MaishaMagavha/Data-Acquisition-Processing-and-Wireless-Transmission-Subsystem-for-the-Red-winged-Starling-Project/Report.pdf

# Chapter 1

# Data Acquisition, Processing, and

# Wireless Transmission

This chapter was written by Maisha Magavha (MGVMAI001)

### 1.1 Introduction

The Data Acquisition, Processing, and Wireless Transmission Subsystem is a crucial component responsible for processing and analyzing the weight measurements and identification data acquired from the sensor subsystem in the Red-winged Starling Project. This subsystem plays a vital role in ensuring accurate weight calibration, associating weight data with the corresponding bird images, and seamlessly transmitting this processed information wirelessly to a local machine for further analysis and storage by the research team.

### 1.2 User Requirements

Code | Requirement | Description
UR1 | Accurate Weight Measurement | The system should accurately measure the weight of Starlings within 140-160 grams.
UR2 | Remote Data Access | Researchers should be able to access the weight measurements and bird identification data re-motely and in real-time.
UR3 | Long-term Deployment | The system should be designed for more than 2 months of outdoor deployment with minimal maintenance requirements, such as infrequent battery replacements.
UR4 | Be able to tell which bird was weighed | The system should associate each weight mea-surement with the corresponding bird identifica-tion data for accurate record-keeping and analy-sis.

Table 1.1: User Requirements (URs)

1.3. Functional Requirements

### 1.3 Functional Requirements

Code | Requirement | User Requirement | ATP
FR1 | The system should remain in a low-power mode until a threshold weight is reached, at which point it should power on and begin weight measurement | UR1 | ATP1
FR2 | The system shall optimize power consumption to facilitate prolonged operation durations. | UR3 | ATP2
FR3 | Develop an algorithm to measure the bird’s weight, perform calibration, and apply filtering techniques. | UR1 | ATP3
FR4 | Implement a mechanism to associate weight data with bird ID images. | UR4 | ATP4
FR5 | Facilitate wireless transmission of associated data to a local server/computer and establish wireless reception of data from a camera. | UR2 | ATP5
FR6 | Implement error handling and data integrity mechanisms to ensure reliable and accurate data transmission, and handle potential communication failures or interruptions. | UR2, UR4 | ATP6

Table 1.2: Functional Requirements (FRs)

### 1.4 Design Specifications

Code | Specification | Targets
DS1 | Implement a low-power mode in the system’s firmware, where it remains in a sleep or deep sleep state until a weight within the range of 150-160g is detected on the scale. | FR1
DS2 | Incorporate power optimization techniques at the hardware and software levels, such as utilizing low-power components, optimizing algorithms for efficient computation, and configuring the system for minimal power consumption during idle or sleep states. | FR2
DS3 | Develop a weight measurement algorithm that incorporates calibration based on the expected range of 140-160g and applies filtering techniques, such as the Kalman filter, to reduce noise and obtain accurate weight measurements. | FR3
DS4 | Implement a mechanism for associating the calibrated weight data with the corre-sponding bird identification images received from the ESP Cam, based on timestamps or other synchronization mechanisms. | FR4
DS5 | Establish a wireless communication protocol between the ESP32 and the computer accessible by the research team. This protocol should allow for the transmission of the associated weight and bird identification data. | FR5

Table 1.3: Design Specifications (DSs)

1.5. ATPs(Acceptance Test Protocols)

### 1.5 ATPs(Acceptance Test Protocols)

Code | Description | URx/FRx
ATP1 | Test the system’s ability to remain in a low-power mode until a weight threshold is reached on the scale. | UR1/FR1
ATP2 | The system’s power consumption is optimized, and it can operate for an extended period without requiring frequent battery replacements or recharging. | UR3/FR2
ATP3 | Verify the system’s ability to accurately measure and calibrate the weight of a known object within the range of 140-160g, and perform any necessary averaging or filtering to obtain an accurate weight value. | UR1/FR3
ATP4 | Test the system’s capability to receive and associate the calibrated weight data with the corresponding bird identification images received from the ESP Cam, and match them based on timestamps or other synchronization mechanisms. | UR4/FR4
ATP5 | The system should correctly transmit the associated weight and bird identification data wirelessly to a local server/computer accessible by the research team. | UR2/FR5
ATP6 | Test the accuracy and efficiency of the Kalman filter implementation by simulating various weight fluctuation scenarios and verifying that the filter effectively smooths out the noise while maintaining responsiveness to actual weight changes. | UR1/FR3
ATP7 | Test the ESP32 Access point configuration and ESP Cam connection | UR2/FR4, FR5

Table 1.4: Acceptance Test Protocols (ATPs)

### 1.6 Design

### 1.6.1 Proposed Solutions

- Microcontroller-based data processing and wireless transmission with external storage (SD Card Module) and Wi-Fi capabilities.
- Microcontroller-based data processing with Bluetooth transmission.
- Microcontroller-based data processing with LoRa (Long-Range) wireless transmission.

A microcontroller with built-in Wi-Fi capabilities and an integrated external storage module is the optimal solution for data processing and transmission. This minimizes the microcontroller’s memory footprint and enables periodic data transmission without disturbing the starling population. Wi-Fi communication ensures reliable long-range data transmission, overcoming Bluetooth’s range limitations and LoRa’s potential throughput issues. The solution includes weight calibration algorithms, data association logic, power management strategies, and weather-proofing for outdoor use. Despite additional complexity and cost, this solution offers efficient data management and reliable wireless communication.

1.6. Design

### 1.6.2 Design Choices

Feature | ESP32 | Raspberry Pi Pico W | Arduino Nano 33 IoT
Cost | R 155.00 | R160.00 | R 537.79
Technical Maturity | - Well-established (2016), Large community, Exten-sive resources | - Relatively new (2022), Growing support | - Arduino plat-form, Large com-munity
Ease of Implemen-tation | High | Moderate | High
Ease of Testing | - Extensive tools, Multi-ple languages, Built-in in-terfaces | - Arduino IDE/C/C++, Built-in USB | - Arduino IDE, Built-in USB
Reliability | - 40nm process, Wide temp. range, Hardware security | - Limited temp. range, No hardware security | - SAMD21 proces-sor, Wide temp. range
Maintenance Costs | Low | Low | Low

Table 1.5: Comparison of Microcontrollers

The ESP32 (HKD WiFi B/T) microcontroller stands out as the optimal choice for this project, meeting its specific requirements with precision. Firstly, its built-in Wi-Fi and Bluetooth capabilities enable seamless wireless communication, critical for transmitting weight data and bird identification images to the research team’s computer in real-time (UR2). Additionally, the ESP32’s low power consumption and efficient operation (UR3) are perfectly suited for prolonged outdoor deployment, minimizing the need for frequent battery replacements. Moreover, the microcontroller’s extensive development ecosystem, boasting multiple programming languages and tools, streamlines the implementation of weight measurement algorithms (FR3), image association (FR4), and wireless data transmission (FR5).

Filter | Advantages | Disadvantages
Moving Average Filter | Simple implementation, Suitable for stationary signals | Limited noise reduction capability, Introduces lag and distortion in dy-namic signals
Low-Pass Filter | Effective in removing high-frequency noise, Suitable for real-time applica-tions | Requires careful tuning of filter pa-rameters, Can introduce ringing ar-tifacts
Kalman Filter | Optimal for linear systems with Gaussian noise, Adapts to changing system dynamics, Provides statisti-cally optimal estimates | Computationally more complex, Re-quires accurate knowledge of sys-tem/noise models

Table 1.6: Comparison of Digital Filtering Techniques

1.6. Design

The Kalman filter was selected for weight data for its numerous benefits, including adaptability to changing system dynamics, statistically optimal estimation by minimizing mean square error, and effective handling of process and measurement noise. Despite its computational complexity, the Kalman filter reliably provides accurate weight estimates, even in the presence of non-stationary behavior or external noise sources, making it ideal for this application. Proper implementation involves developing an accurate model of the weight measurement process and noise characteristics, followed by parameter initialization and tuning based on empirical testing and validation.

### 1.6.3 Preliminary Tests and Design Iteration

During the initial testing phase, the SD card initialization process encountered frequent failures, as evident from the error message ‘Card Mount Failed’ in the log.

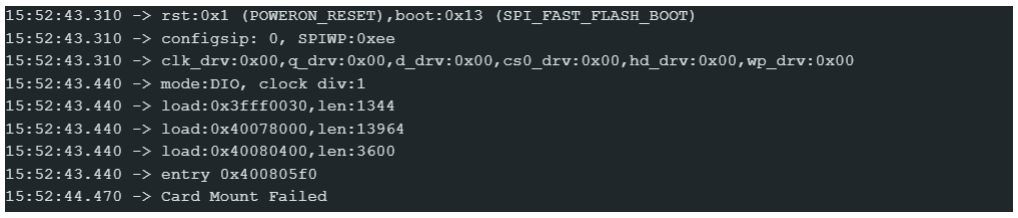
[picture p1: figure]

Figure 1.1: SD Card Initialization.

This issue raised concerns about the reliability and stability of the SD card module, which could lead to potential data loss or corruption. To address this problem, the decision was made to discard the SD card module from the design. Instead of relying on persistent local storage, the system will temporarily store the data in memory (RAM) until it is successfully transmitted to the web server. The revised design incorporates the following modifications:

- Instead of writing data to an SD card, the system will store the JSON data and image data in memory (RAM) until it is successfully transmitted to the web server.
- To optimize memory usage, the system will encode the image data using Base64, a more compact representation than raw image formats like JPEG or PNG.
- After each successful HTTP POST request to the web server, the system will clear the contents of the JSON data and Base64-encoded image data from memory, freeing up space for the next set of measurements and images.

By implementing these changes, the system aims to achieve a more reliable and efficient data transmission process, while minimizing the risk of data loss or corruption.

1.6. Design

### 1.6.4 Final Design

This section provides an overview of the key components used in our prototype and how they are connected.

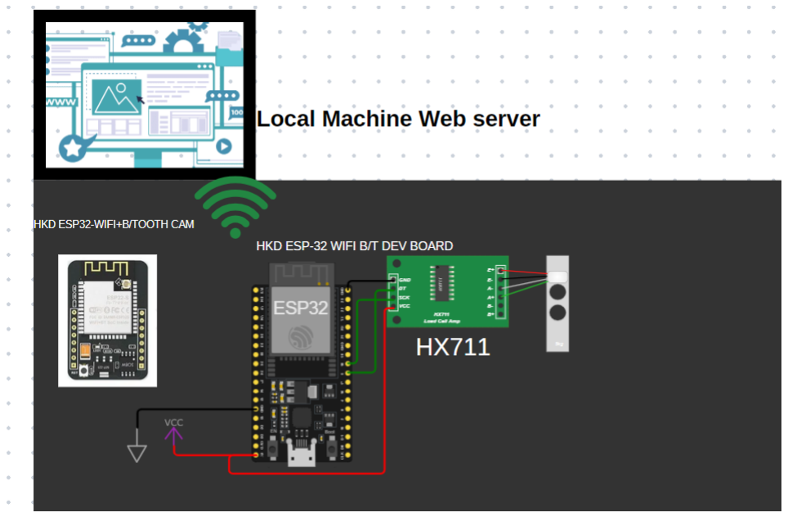
[picture p2: figure]

Figure 1.2: Data Processing and Wireless Transmission submodule combined with some blocks from the sensing submodule and the user interface.

HKD ESP-32 WiFi B/T DEV BOARD This is the main processing unit of the operation:

- Configuring itself as a WiFi Access Point (AP) with a specific SSID and password, allowing the ESP32-CAM to connect to it. It receives the captured images wirelessly from the ESP32-CAM using UDP communication.
- Receiving raw data for weight measurements from the HX711 load cell amplifier.
- Implementing weight calibration algorithms and applying a Kalman filter for accurate weight estimation, especially for moving weights.
- Associating the calibrated weight data with the corresponding bird images received from the ESP32-CAM by requesting the latest image every time a weight threshold is reached.
- Storing the processed data (weight measurements and associated bird images) in a JSON file, and transmitting the JSON file wirelessly to a local machine web server upon request.
- Managing power consumption by entering deep sleep mode when the weight is below a predefined threshold, and waking up when a bird lands on the scale, causing the weight to exceed the threshold.

1.6. Design

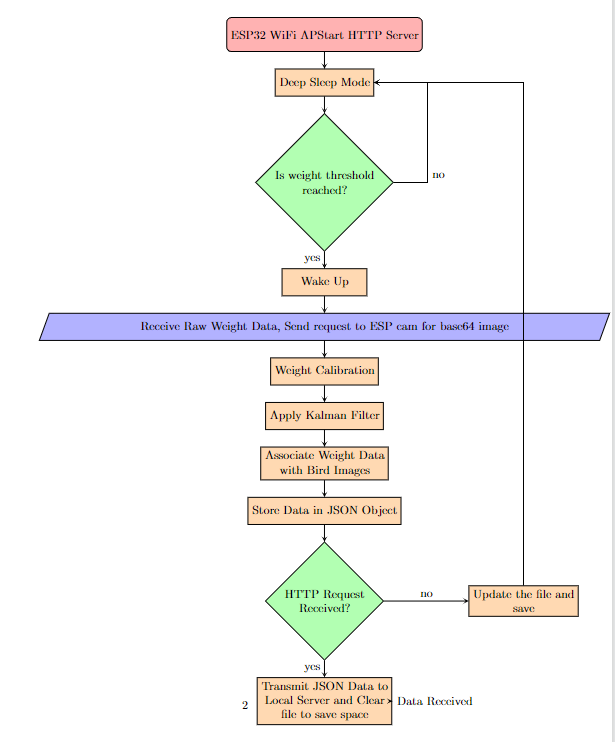
[picture p3: figure]

Figure 1.3: Flow Chart

Implementation Details

ESP32 as WiFi Access Point (AP) The ESP32 is configured to create a WiFi Access Point (AP) with a specified SSID and password. This allows the ESP32-CAM to connect to the AP wirelessly.

Deep Sleep Mode and Weight Threshold Detection The system enters deep sleep mode when the weight on the scale is below a predefined threshold. It wakes up from deep sleep when the weight exceeds the threshold, indicating that a bird has landed on the scale.

Weight Calibration The weight calibration and conversion of raw values from the HX711 load cell amplifier are performed using an algorithm implemented in the ESP32. The ESP32 receives the raw weight values from the HX711’s digital output pin using the ‘digitalRead()‘ function. A calibration factor is then applied to the raw values to obtain the final calibrated weight measurements. The algorithm also includes taring (zeroing) the scale before taking measurements to account for the weight of the scale itself.

Kalman Filter A Kalman filter implementation is used to estimate the weight from a series of noisy measurements. The filter helps smooth out noise while remaining responsive to actual weight changes.

JSON Object The processed data, including weight measurements, timestamps, and associated bird images (encoded in Base64), is stored in a JSON object.

1.7. Testing

Wireless Data Transmission The JSON object containing the processed data is transmitted wirelessly to a local machine web server upon request. The server handles the incoming requests, serializes the JSON object, and sends the data back to the client with the appropriate headers.

### 1.7 Testing

ATP1

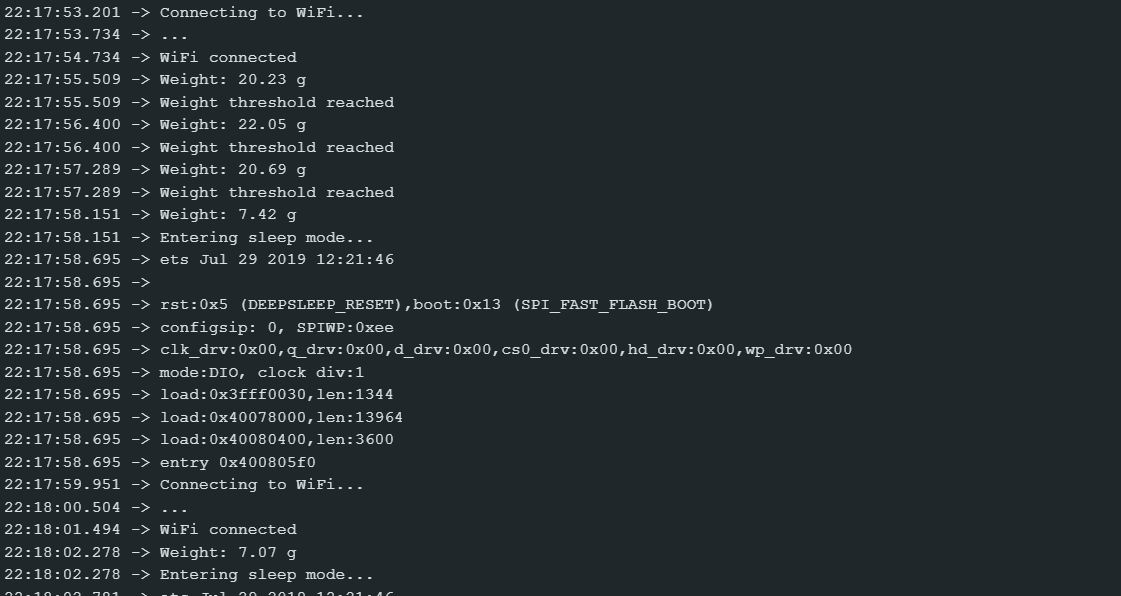
[picture p4: figure]

Figure 1.4: The ESP32 entering low-power sleep mode.

- Description: Test the system’s ability to remain in a low-power mode until a weight threshold is reached on the scale.
- Test Procedure: Placed known weights below and above the 10g threshold on the scale. Observed the system’s behavior in terms of entering and exiting the low-power sleep mode.
- Expected Results: The system should remain in a low-power mode and wake up only when the weight on the scale exceeds the predefined threshold weight.
- Actual Results: The test in figure 1.4 shows that the system successfully entered sleep mode when the measured weight was below the set threshold of 10g and woke up when the threshold weight was reached, matching the expected behavior.

ATP2

- Description: The system’s power consumption is optimized, and it can operate for an extended period without requiring frequent battery replacements or recharging.
- Test Procedure: No long-term testing was done.
- Expected Results: The system should operate for a period of 2 months without needing battery replacement or recharging.
- Actual Results: ATP2 could not undergo a comprehensive evaluation at this stage due to the necessity for long-term testing over an extended duration. However, preliminary tests and simulations were conducted to evaluate the power optimization strategies, yielding promising results regarding power consumption.

1.7. Testing

ATP3

- Description: Verify the system’s ability to accurately measure and calibrate the weight of a known object within the range of 140-160g, and perform any necessary averaging or filtering to obtain an accurate weight value.
- Test Procedure: Placed a known 150g weight on the scale and simulated bird movement by moving the weight around. Observed the system’s weight measurements and filtering/averaging techniques.
- Expected Results: The system should accurately measure and calibrate the weight within the range of 140-160g, applying any necessary averaging or filtering techniques to obtain an accurate weight value.
- Actual Results: The system accurately measured and calibrated the weight within the expected 140-160g range as shown in figure 1.6, with filtered weight values ranging from 149.8g to 150.8g, demonstrating effective filtering/averaging techniques.

ATP4

- Description: Test the system’s capability to receive and associate the calibrated weight data with the corresponding bird identification images received from the ESP Cam, and match them based on timestamps or other synchronization mechanisms.
- Test Procedure: Place a known weight on the scale to simulate a bird landing, capture an image of the known weight using the ESP Cam and transmit it to the ESP32, Observe the system’s behavior in associating the calibrated weight data with the received image.
- Expected Results: Using timestamps or other synchronization mechanisms, the system should correctly associate the calibrated weight data with the corresponding bird identification images received from the ESP Cam.
- Actual Results: The system correctly associates the weight data with the base64 image data as shown in figure 1.5 were the Data being sent is printed right before sending.

ATP5

Figure 1.5: Sending Data to the web server

- Description: The system should correctly transmit the associated weight and bird identification data wirelessly to a local server/computer accessible by the research team.
- Test Procedure: Observed the wireless transmission of weight and bird identification data from the system to a local computer.
- Expected Results: The system should successfully transmit the associated weight and bird identification data wirelessly to a local server/computer accessible by the research team.

1.7. Testing
- Actual Results: The system correctly transmitted the associated weight and bird identification data wirelessly to a computer, satisfying ATP5. The data was transmitted in JSON format, and the process repeated for subsequent requests, transmitting the latest weight, timestamp, and image data each time.

ATP6

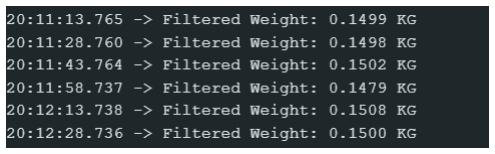
[picture p5: figure]
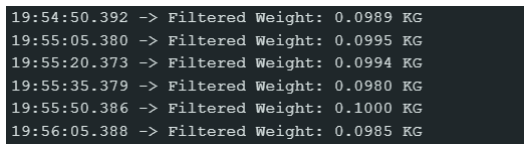
[picture p6: figure]

(a) 100 grams weight on the scale | (b) 150 grams weight on the scale

Figure 1.6: Results when weight are placed on the scale while mimicking birds movement.

- Description: Test the accuracy and efficiency of the Kalman filter implementation by simulating various weight fluctuation scenarios and verifying that the filter effectively smooths out the noise while maintaining responsiveness to actual weight changes.
- Test Procedure: Simulated bird movements using known weights of 100g and 150g, and observed the filtered weight values.
- Expected Results: The Kalman filter should effectively smooth out noise in the weight measurements while remaining responsive to actual weight changes.
- Actual Results: When subjected to simulated bird movements, the filtered weight values consistently ranged from 98.5g to 100g for the 100g weight, and from 149.8g to 150.8g for the 150g weight, closely mirroring the actual weights. The Kalman filter successfully mitigated fluctuations induced by movement while maintaining accuracy, demonstrating its suitability for this application.

ATP7

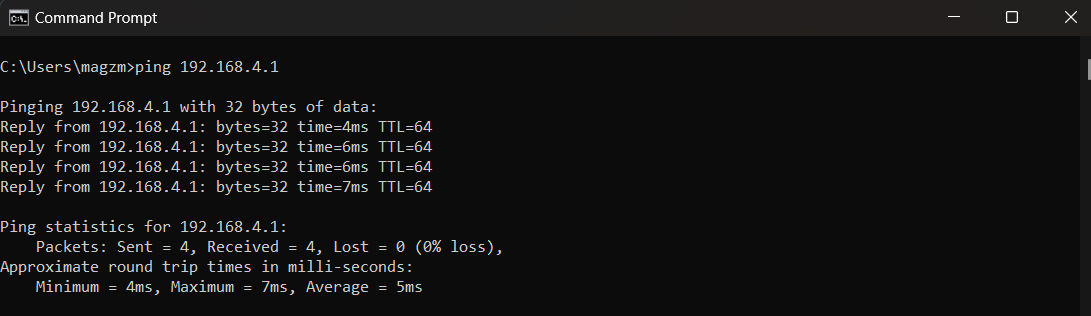
[picture p7: figure]

Figure 1.7: Perfoming a ping test.

- Description: Test the ESP32 Access point configuration and ESP Cam connection.
- Test Procedure: Performed a ping test to check the wireless connection between the ESP32 (configured as an Access Point) and the ESP Cam.
- Expected Results: The ESP32 should successfully create an access point, and the ESP Cam should connect to it without any issues.

1.8. Conclusion
- Actual Results: The ping test demonstrated that the ESP32 was correctly configured as an Access Point (AP) and could establish a stable and responsive wireless connection with the ESP Cam, with Round Trip Times (RTTs) of approximately 4-7ms, satisfying the requirements of ATP7.

### 1.8 Conclusion

The Data Acquisition, Processing, and Wireless Transmission Subsystem successfully fulfills the project’s requirements by accurately measuring starling weights, associating them with corresponding bird images, and seamlessly transmitting the processed data wirelessly. The system leverages an ESP32 microcontroller configured as a WiFi Access Point, enabling communication with an ESP32-CAM for image acquisition.

Extensive testing validated the system’s ability to measure weights within the 140-160g range, associate weight data with images, transmit data wirelessly, and effectively smooth noise using a Kalman filter. The power management strategies, including deep sleep mode and wake-up based on weight thresholds, contribute to optimized power consumption for long-term deployment.

While comprehensive long-term power consumption testing was not feasible at this stage, preliminary assessments yielded promising results. Overall, this subsystem provides a robust solution for accurate data acquisition, processing, and wireless transmission, enabling remote access and analysis by the research team.

1.8. Conclusion

Student Number: MGVMAI001

Subsystem Title | Where Met
GA 3: Engineering Design | Sections 1.2, 1.3, 1.4, 1.6
GA 7: Sustainability and Impact of Engineering Activity | D-School Sections1.2(UR3), 1.6.2 (low power design choices)
GA 8: Individual, Team and Multi-disciplinary Working | Teams group for meeting min-utes
GA 10: Engineering Professionalism | All submission activities met including final report and pre-sentation.

Table 1.7: GA Table

For GA 3, the user requirements, functional requirements, design specifications and final design choices covered the key aspects of engineering design for this subsystem.

For GA 7, the focus on low-power operation for long-term outdoor deployment and the analysis of different microcontroller options based on power consumption addresses sustainability considerations.
