MaishaMagavha/Data-Acquisition-Processing-and-Wireless-Transmission-Subsystem-for-the-Red-winged-Starling-Project/100Grams_TimeStamp - Copy.png

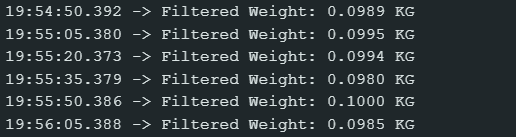
100Grams_TimeStamp - Copy.png
