MaishaMagavha/Data-Acquisition-Processing-and-Wireless-Transmission-Subsystem-for-the-Red-winged-Starling-Project/150Grams_TimeStamp.png

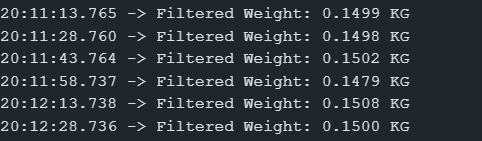
150Grams_TimeStamp.png
