MaishaMagavha/Data-Acquisition-Processing-and-Wireless-Transmission-Subsystem-for-the-Red-winged-Starling-Project/Card_Failed.png

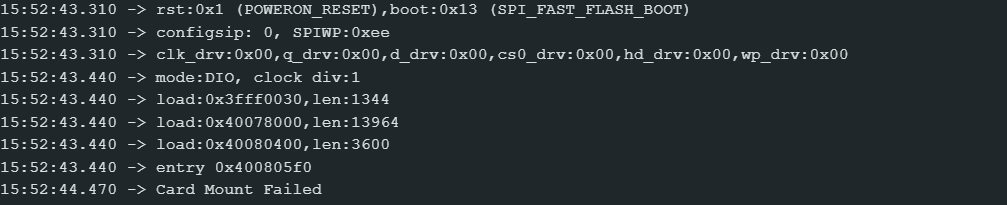
Card_Failed.png
