MaishaMagavha/Data-Acquisition-Processing-and-Wireless-Transmission-Subsystem-for-the-Red-winged-Starling-Project/FiftyGrams_TimeStamp - Copy.png

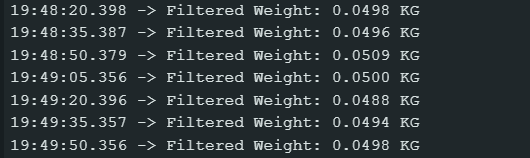
FiftyGrams_TimeStamp - Copy.png
